nekobako/Mew40/README.md

| English | [日本語](README-ja-jp.md) |

# Mew40
A low-profile, unibody keyboard with a 40% ortholinear layout.

Mew40 CNC

Mew40 3DP

## Key Features
- 48-key ortholinear layout arranged in 4 rows of 12 keys
- Hot-swappable 3-pin switches compatible with Choc V2
- Full color backlighting for every key
- Choice of an aluminum case machined by CNC or a resin case made with 3D printing
- Keymap customization with Vial

## Build Guide
[Build Guide | Mew40](https://mew40.nekobako.net/build-guide/)

## License
| Component | License | Third Party Notices |
| --- | --- | --- |
| [PCB](./PCB/) | [LICENSE.md](./PCB/LICENSE.md) | [THIRD-PARTY-NOTICES.md](./PCB/THIRD-PARTY-NOTICES.md) |
| [Case](./Case/) | [LICENSE.md](./Case/LICENSE.md) | [THIRD-PARTY-NOTICES.md](./Case/THIRD-PARTY-NOTICES.md) |
| [Firmware](./Firmware/) | [LICENSE.md](./Firmware/LICENSE.md) | [THIRD-PARTY-NOTICES.md](./Firmware/THIRD-PARTY-NOTICES.md) |
