nekobako/Mew40/Website/en-us/index.md

---
layout: home
hero:
  name: "Mew40"
  tagline: "A low-profile, unibody keyboard\nwith a 40% ortholinear layout"
  image:
    src: "/images/mew40-cnc.png"
    alt: "Mew40"
  actions:
    - theme: brand
      text: "Buy on BOOTH"
      link: "https://nekobako.booth.pm"
    - theme: alt
      text: "Build Guide"
      link: "./build-guide/"
features:
  - icon: "⌨️"
    title: "40% Ortholinear Layout"
    details: "48-key ortholinear layout arranged in 4 rows of 12 keys"
  - icon: "🍫"
    title: "Low Profile"
    details: "Hot-swappable 3-pin switches compatible with Choc V2"
  - icon: "🌈"
    title: "Per-Key RGB Backlighting"
    details: "Full color backlighting for every key"
  - icon: "⚗️"
    title: "Custom Keymaps"
    details: "Keymap customization with Vial"
---
