nekobako/Mew40/Website/en-us/license/index.md

# License
License information for the Mew40 DIY keyboard kit.

- [PCB](./pcb)
- [Case](./case)
- [Firmware](./firmware)
