nekobako/Mew40/Website/ja-jp/license/index.md

# ライセンス
自作キーボードキット Mew40 のライセンス情報です。

- [基板](./pcb)
- [ケース](./case)
- [ファームウェア](./firmware)
