nekobako/Mew40/Website/ja-jp/index.md

---
layout: home
hero:
  name: "Mew40"
  tagline: "40% オーソリニア配列を採用した\nロープロファイルの一体型キーボード"
  image:
    src: "/images/mew40-cnc.png"
    alt: "Mew40"
  actions:
    - theme: brand
      text: "BOOTH で購入"
      link: "https://nekobako.booth.pm"
    - theme: alt
      text: "ビルドガイド"
      link: "./build-guide/"
features:
  - icon: "⌨️"
    title: "40% オーソリニア配列"
    details: "4 行 × 12 列、計 48 キーのオーソリニア配列"
  - icon: "🍫"
    title: "ロープロファイル"
    details: "Choc V2 互換 3 ピンスイッチのホットスワップに対応"
  - icon: "🌈"
    title: "バックライト搭載"
    details: "すべてのキーにフルカラーバックライトを搭載"
  - icon: "⚗️"
    title: "カスタムキーマップ"
    details: "Vial によるキーマップ変更に対応"
---
