nekobako/Mew40/Case/Mew40_3DP.FCStd

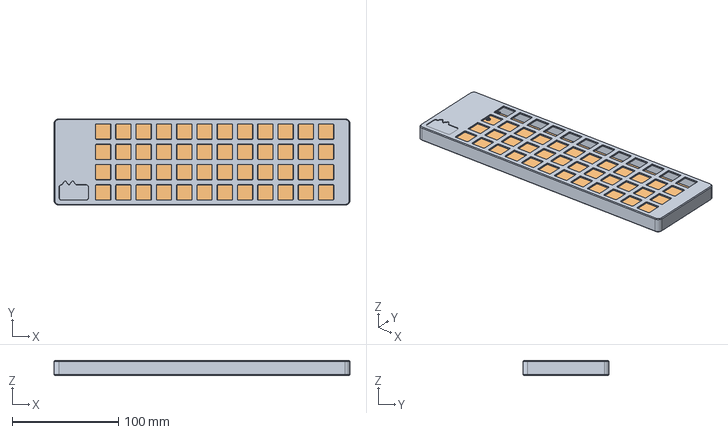
[picture p1: CAD file, 2026-11-14]
Case/Mew40_3DP.FCStd
278.2 x 81.2 x 14.0 mm
Top_Body
Bottom_Body
