nekobako/Mew40/Case/Mew40_CNC.FCStd

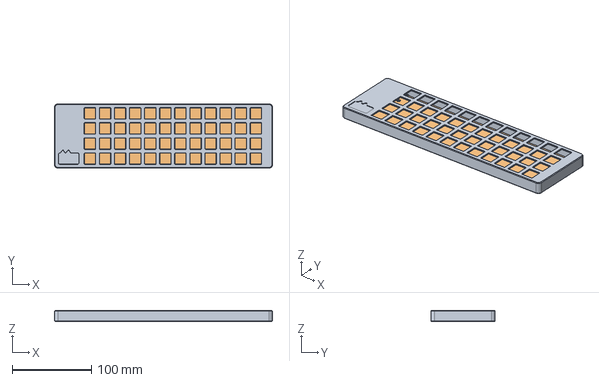
[picture p2: CAD file, 2026-11-14]
Case/Mew40_CNC.FCStd
275.3 x 81.2 x 14.0 mm
Top_Body
Bottom_Body
