nekobako/Mew40/Website/en-us/build-guide/index.md

# Build Guide
Build guide for the Mew40 DIY keyboard kit.

- [Preparation](./preparation)
- [Soldering](./soldering)
- [Assembly](./assembly)
- [Firmware](./firmware)
- [Finishing](./finishing)
