nekobako/Mew40/Website/ja-jp/build-guide/index.md

# ビルドガイド
自作キーボードキット Mew40 のビルドガイドです。

- [準備](./preparation)
- [はんだ付け](./soldering)
- [組み立て](./assembly)
- [ファームウェア](./firmware)
- [仕上げ](./finishing)
