nekobako/Mew40/Website/images/build-guide/finishing/3.png

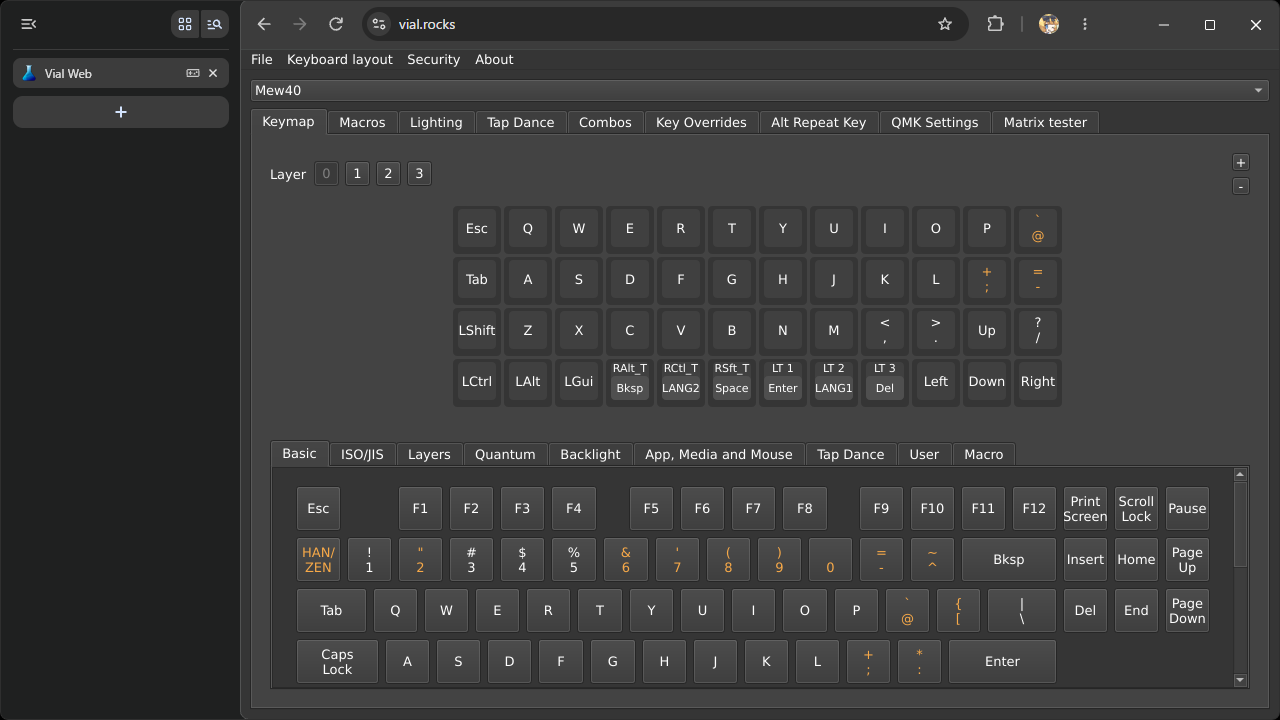
Website/images/build-guide/finishing/3.png
