nekobako/Mew40/Website/images/build-guide/finishing/4.png

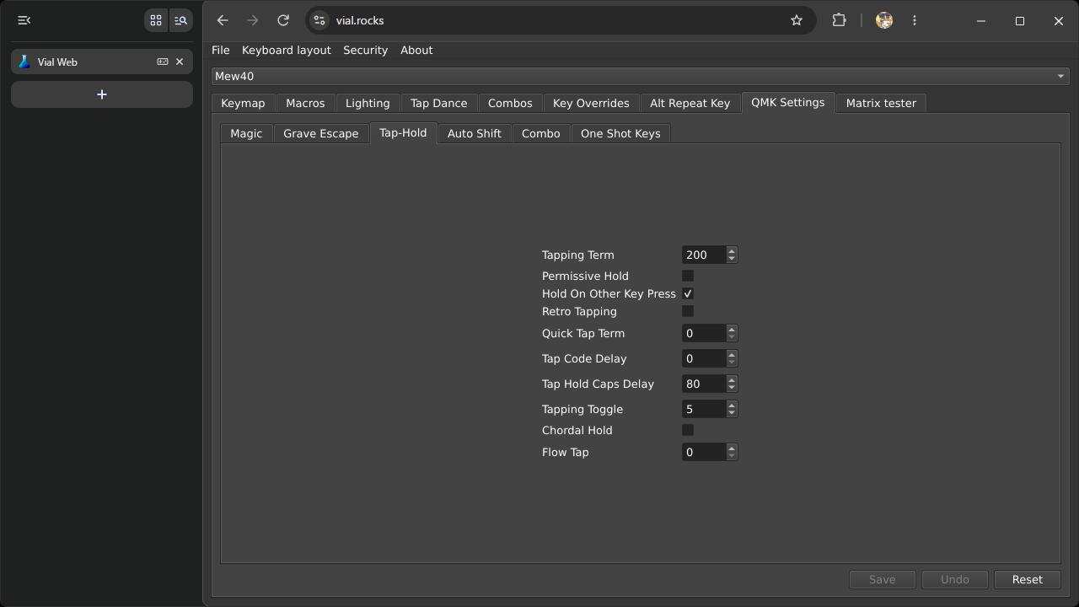
Website/images/build-guide/finishing/4.png
