nekobako/Mew40/Website/images/build-guide/firmware/2.png

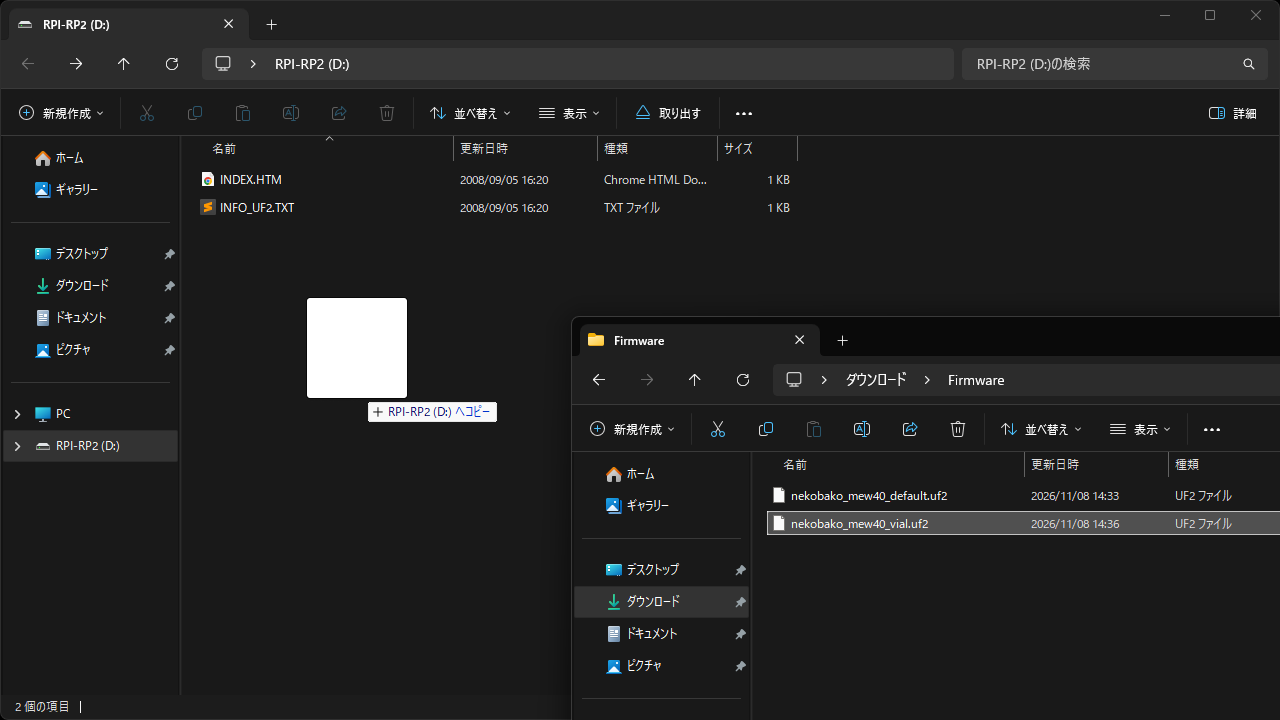
Website/images/build-guide/firmware/2.png
