nekobako/Mew40/Website/images/build-guide/firmware/3.png

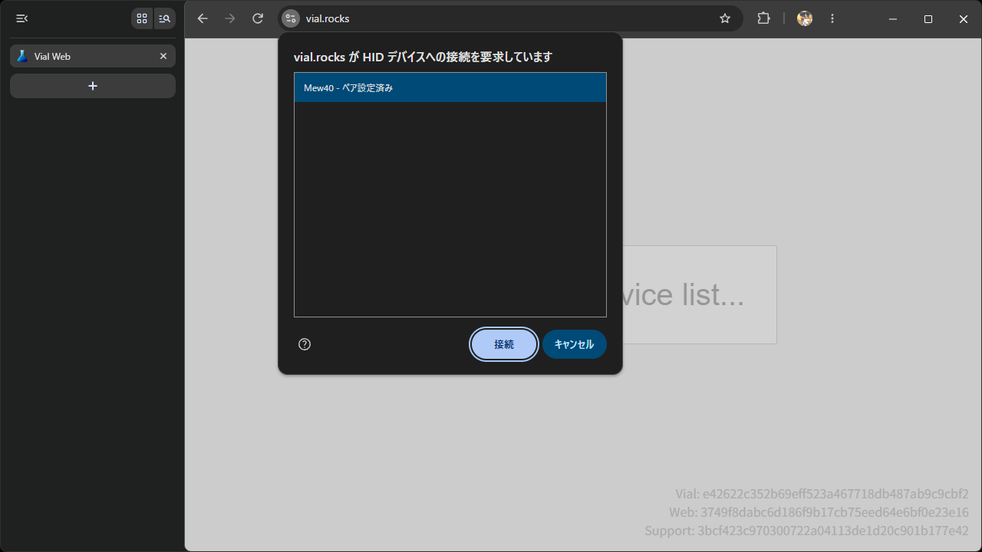
Website/images/build-guide/firmware/3.png
