nekobako/Mew40/PCB/Mew40.kicad_pcb

## KiCad design PCB/Mew40.kicad_pcb (2026-11-14)

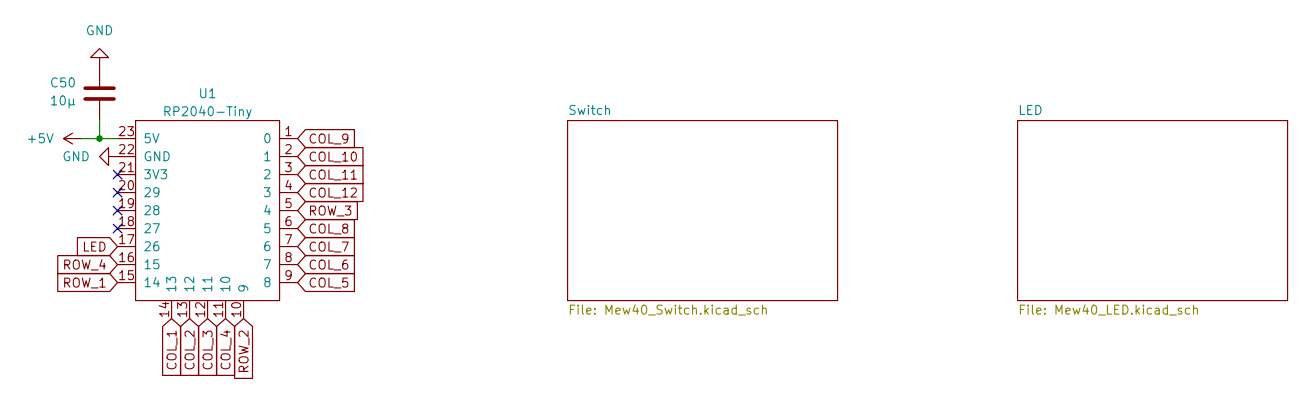
[picture p8: schematic Mew40.kicad_sch]

Parts:
C50: 10µ; C_1206_3216Metric
U1: RP2040-Tiny; Waveshare_RP2040-Zero_SMD

Connections:
+5V: C50.2, U1.23 (5V); also elsewhere on the board
COL_1: U1.14 (13); also elsewhere on the board
COL_2: U1.13 (12); also elsewhere on the board
COL_3: U1.12 (11); also elsewhere on the board
COL_4: U1.11 (10); also elsewhere on the board
COL_5: U1.9 (8); also elsewhere on the board
COL_6: U1.8 (7); also elsewhere on the board
COL_7: U1.7 (6); also elsewhere on the board
COL_8: U1.6 (5); also elsewhere on the board
COL_9: U1.1 (0); also elsewhere on the board
COL_10: U1.2 (1); also elsewhere on the board
COL_11: U1.3 (2); also elsewhere on the board
COL_12: U1.4 (3); also elsewhere on the board
GND: C50.1, U1.22 (GND); also elsewhere on the board
LED: U1.17 (26); also elsewhere on the board
ROW_1: U1.15 (14); also elsewhere on the board
ROW_2: U1.10 (9); also elsewhere on the board
ROW_3: U1.5 (4); also elsewhere on the board
ROW_4: U1.16 (15); also elsewhere on the board

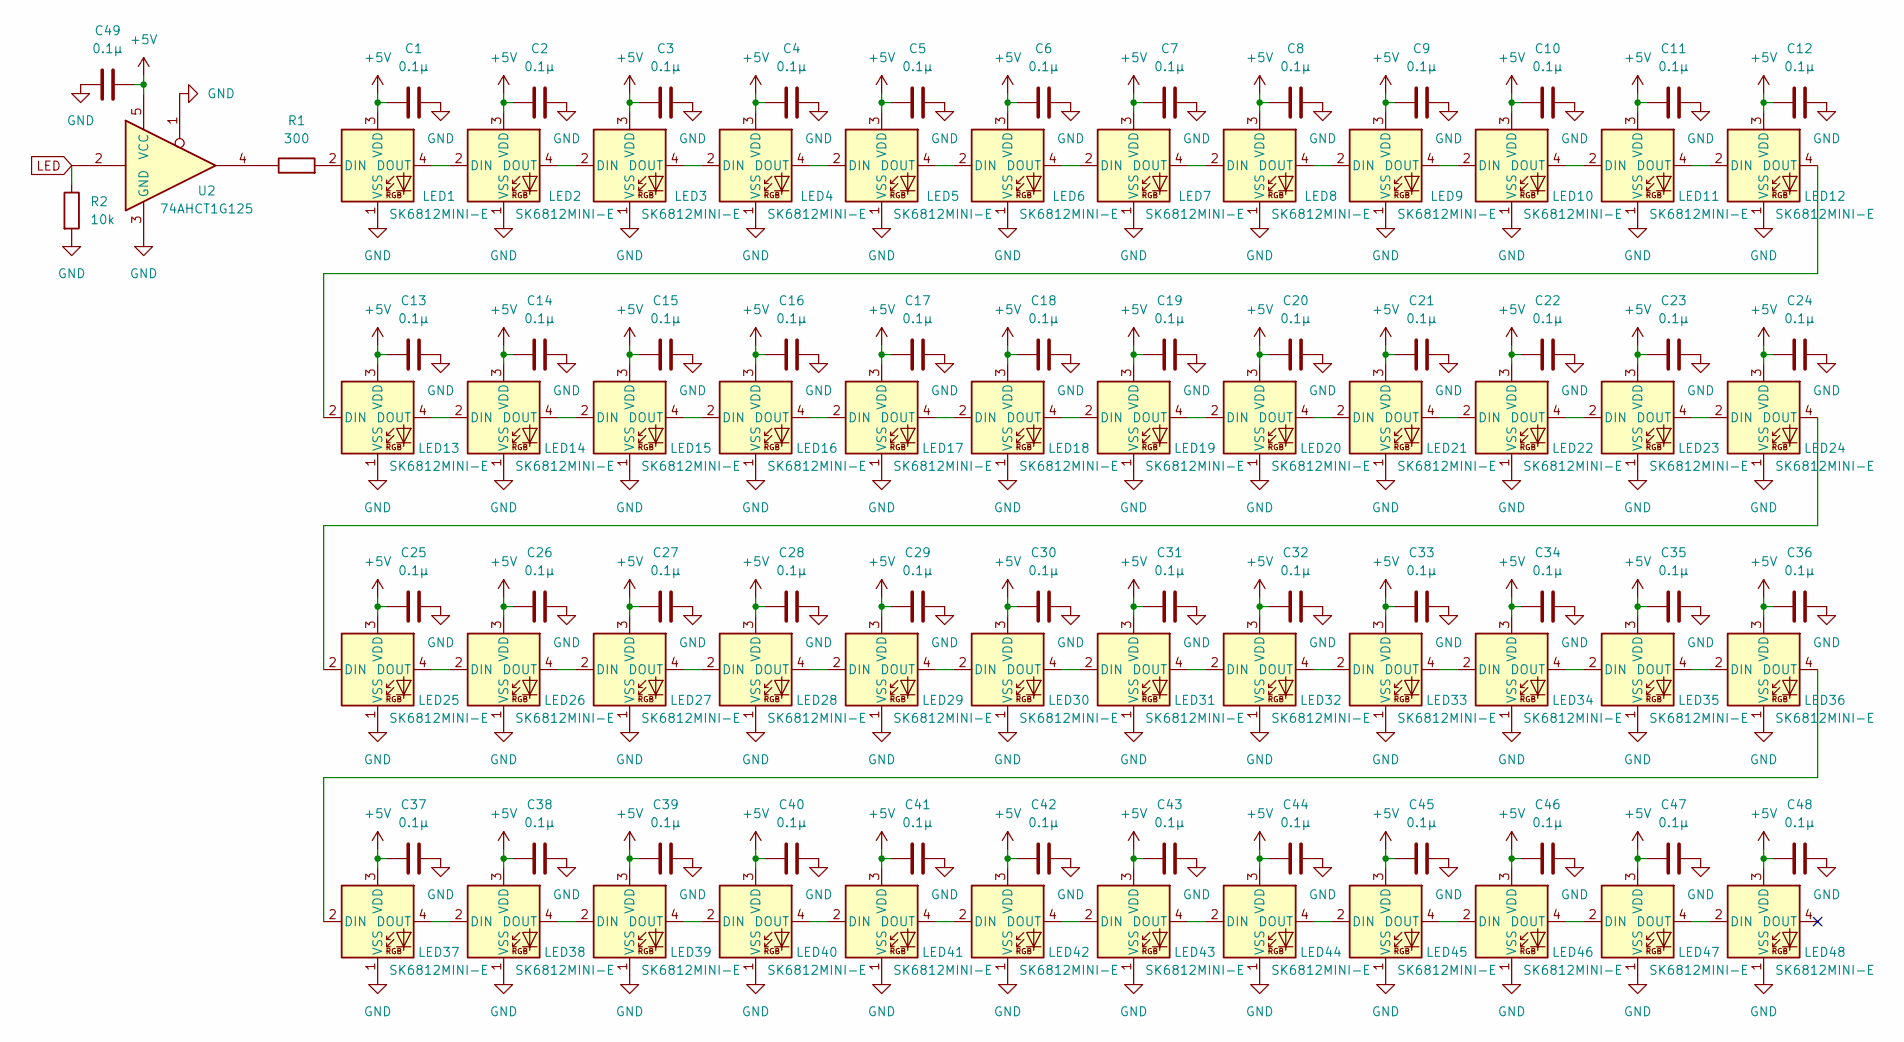
[picture p9: schematic Mew40_LED.kicad_sch, Mew40]

Parts:
C1, C2, C3, C4, C5, C6, C7, C8, C9, C10, C11, C12, C13, C14, C15, C16, C17, C18, C19, C20, C21, C22, C23, C24, C25, C26, C27, C28, C29, C30, C31, C32, C33, C34, C35, C36, C37, C38, C39, C40, C41, C42, C43, C44, C45, C46, C47, C48, C49: 0.1µ; C_0603_1608Metric
LED1, LED2, LED3, LED4, LED5, LED6, LED7, LED8, LED9, LED10, LED11, LED12, LED13, LED14, LED15, LED16, LED17, LED18, LED19, LED20, LED21, LED22, LED23, LED24, LED25, LED26, LED27, LED28, LED29, LED30, LED31, LED32, LED33, LED34, LED35, LED36, LED37, LED38, LED39, LED40, LED41, LED42, LED43, LED44, LED45, LED46, LED47, LED48: SK6812MINI-E; LED_SK6812MINI-E_3.2x2.8mm_P1.5mm_ReverseMount
R1: 300; R_0603_1608Metric
R2: 10k; R_0603_1608Metric
U2: 74AHCT1G125; SOT-23-5

Connections:
+5V: C1.1, C2.1, C3.1, C4.1, C5.1, C6.1, C7.1, C8.1, C9.1, C10.1, C11.1, C12.1, C13.1, C14.1, C15.1, C16.1, C17.1, C18.1, C19.1, C20.1, C21.1, C22.1, C23.1, C24.1, C25.1, C26.1, C27.1, C28.1, C29.1, C30.1, C31.1, C32.1, C33.1, C34.1, C35.1, C36.1, C37.1, C38.1, C39.1, C40.1, C41.1, C42.1, C43.1, C44.1, C45.1, C46.1, C47.1, C48.1, C49.2, LED1.3 (VDD), LED2.3 (VDD), LED3.3 (VDD), LED4.3 (VDD), LED5.3 (VDD), LED6.3 (VDD), LED7.3 (VDD), LED8.3 (VDD), LED9.3 (VDD), LED10.3 (VDD), LED11.3 (VDD), LED12.3 (VDD), LED13.3 (VDD), LED14.3 (VDD), LED15.3 (VDD), LED16.3 (VDD), LED17.3 (VDD), LED18.3 (VDD), LED19.3 (VDD), LED20.3 (VDD), LED21.3 (VDD), LED22.3 (VDD), LED23.3 (VDD), LED24.3 (VDD), LED25.3 (VDD), LED26.3 (VDD), LED27.3 (VDD), LED28.3 (VDD), LED29.3 (VDD), LED30.3 (VDD), LED31.3 (VDD), LED32.3 (VDD), LED33.3 (VDD), LED34.3 (VDD), LED35.3 (VDD), LED36.3 (VDD), LED37.3 (VDD), LED38.3 (VDD), LED39.3 (VDD), LED40.3 (VDD), LED41.3 (VDD), LED42.3 (VDD), LED43.3 (VDD), LED44.3 (VDD), LED45.3 (VDD), LED46.3 (VDD), LED47.3 (VDD), LED48.3 (VDD), U2.5 (VCC); also elsewhere on the board
GND: C1.2, C2.2, C3.2, C4.2, C5.2, C6.2, C7.2, C8.2, C9.2, C10.2, C11.2, C12.2, C13.2, C14.2, C15.2, C16.2, C17.2, C18.2, C19.2, C20.2, C21.2, C22.2, C23.2, C24.2, C25.2, C26.2, C27.2, C28.2, C29.2, C30.2, C31.2, C32.2, C33.2, C34.2, C35.2, C36.2, C37.2, C38.2, C39.2, C40.2, C41.2, C42.2, C43.2, C44.2, C45.2, C46.2, C47.2, C48.2, C49.1, LED1.1 (VSS), LED2.1 (VSS), LED3.1 (VSS), LED4.1 (VSS), LED5.1 (VSS), LED6.1 (VSS), LED7.1 (VSS), LED8.1 (VSS), LED9.1 (VSS), LED10.1 (VSS), LED11.1 (VSS), LED12.1 (VSS), LED13.1 (VSS), LED14.1 (VSS), LED15.1 (VSS), LED16.1 (VSS), LED17.1 (VSS), LED18.1 (VSS), LED19.1 (VSS), LED20.1 (VSS), LED21.1 (VSS), LED22.1 (VSS), LED23.1 (VSS), LED24.1 (VSS), LED25.1 (VSS), LED26.1 (VSS), LED27.1 (VSS), LED28.1 (VSS), LED29.1 (VSS), LED30.1 (VSS), LED31.1 (VSS), LED32.1 (VSS), LED33.1 (VSS), LED34.1 (VSS), LED35.1 (VSS), LED36.1 (VSS), LED37.1 (VSS), LED38.1 (VSS), LED39.1 (VSS), LED40.1 (VSS), LED41.1 (VSS), LED42.1 (VSS), LED43.1 (VSS), LED44.1 (VSS), LED45.1 (VSS), LED46.1 (VSS), LED47.1 (VSS), LED48.1 (VSS), R2.2, U2.1, U2.3 (GND); also elsewhere on the board
LED: R2.1, U2.2; also elsewhere on the board
unnamed: LED1.2 (DIN), R1.2
unnamed: LED1.4 (DOUT), LED2.2 (DIN)
unnamed: LED2.4 (DOUT), LED3.2 (DIN)
unnamed: LED3.4 (DOUT), LED4.2 (DIN)
unnamed: LED4.4 (DOUT), LED5.2 (DIN)
unnamed: LED5.4 (DOUT), LED6.2 (DIN)
unnamed: LED6.4 (DOUT), LED7.2 (DIN)
unnamed: LED7.4 (DOUT), LED8.2 (DIN)
unnamed: LED8.4 (DOUT), LED9.2 (DIN)
unnamed: LED9.4 (DOUT), LED10.2 (DIN)
unnamed: LED10.4 (DOUT), LED11.2 (DIN)
unnamed: LED11.4 (DOUT), LED12.2 (DIN)
unnamed: LED12.4 (DOUT), LED13.2 (DIN)
unnamed: LED13.4 (DOUT), LED14.2 (DIN)
unnamed: LED14.4 (DOUT), LED15.2 (DIN)
unnamed: LED15.4 (DOUT), LED16.2 (DIN)
unnamed: LED16.4 (DOUT), LED17.2 (DIN)
unnamed: LED17.4 (DOUT), LED18.2 (DIN)
unnamed: LED18.4 (DOUT), LED19.2 (DIN)
unnamed: LED19.4 (DOUT), LED20.2 (DIN)
unnamed: LED20.4 (DOUT), LED21.2 (DIN)
unnamed: LED21.4 (DOUT), LED22.2 (DIN)
unnamed: LED22.4 (DOUT), LED23.2 (DIN)
unnamed: LED23.4 (DOUT), LED24.2 (DIN)
unnamed: LED24.4 (DOUT), LED25.2 (DIN)
unnamed: LED25.4 (DOUT), LED26.2 (DIN)
unnamed: LED26.4 (DOUT), LED27.2 (DIN)
unnamed: LED27.4 (DOUT), LED28.2 (DIN)
unnamed: LED28.4 (DOUT), LED29.2 (DIN)
unnamed: LED29.4 (DOUT), LED30.2 (DIN)
unnamed: LED30.4 (DOUT), LED31.2 (DIN)
unnamed: LED31.4 (DOUT), LED32.2 (DIN)
unnamed: LED32.4 (DOUT), LED33.2 (DIN)
unnamed: LED33.4 (DOUT), LED34.2 (DIN)
unnamed: LED34.4 (DOUT), LED35.2 (DIN)
unnamed: LED35.4 (DOUT), LED36.2 (DIN)
unnamed: LED36.4 (DOUT), LED37.2 (DIN)
unnamed: LED37.4 (DOUT), LED38.2 (DIN)
unnamed: LED38.4 (DOUT), LED39.2 (DIN)
unnamed: LED39.4 (DOUT), LED40.2 (DIN)
unnamed: LED40.4 (DOUT), LED41.2 (DIN)
unnamed: LED41.4 (DOUT), LED42.2 (DIN)
unnamed: LED42.4 (DOUT), LED43.2 (DIN)
unnamed: LED43.4 (DOUT), LED44.2 (DIN)
unnamed: LED44.4 (DOUT), LED45.2 (DIN)
unnamed: LED45.4 (DOUT), LED46.2 (DIN)
unnamed: LED46.4 (DOUT), LED47.2 (DIN)
unnamed: LED47.4 (DOUT), LED48.2 (DIN)
unnamed: R1.1, U2.4

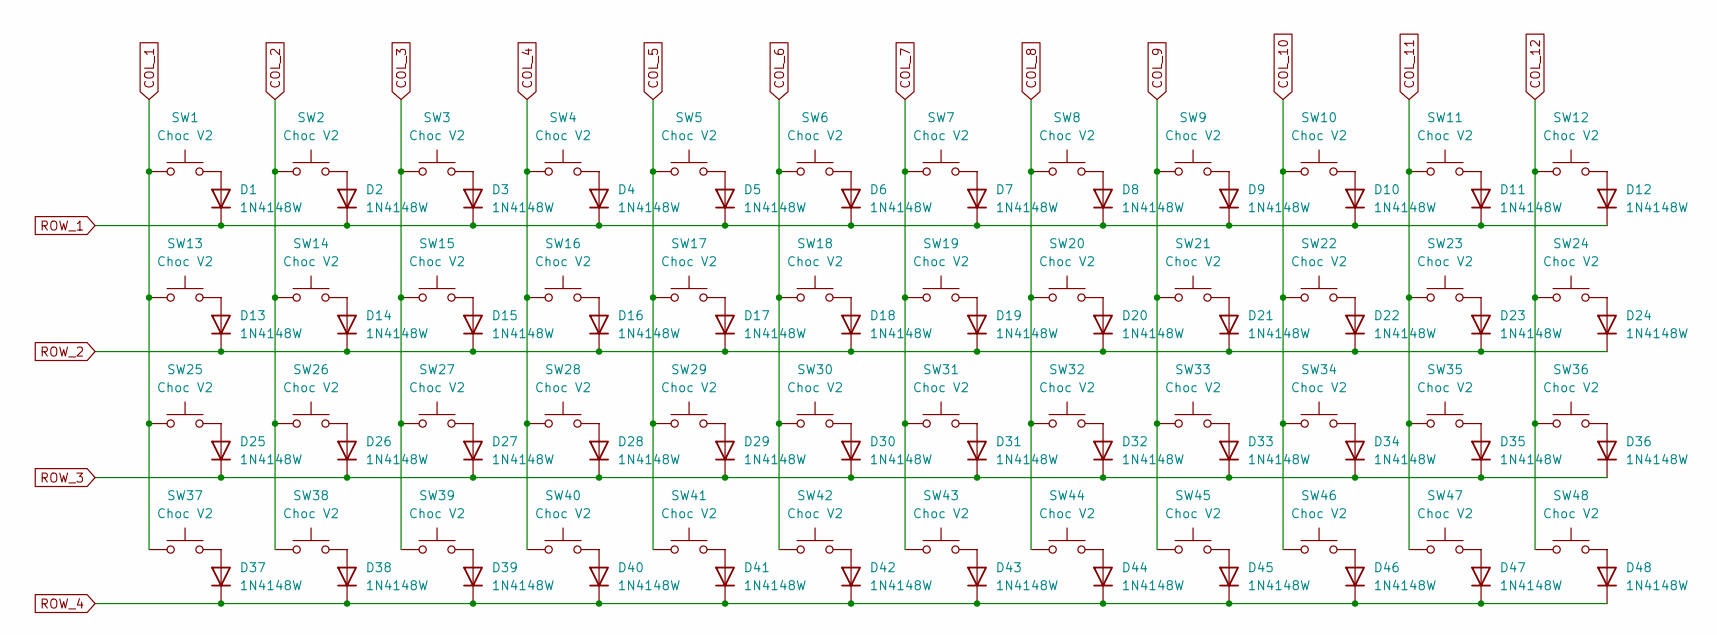
[picture p10: schematic Mew40_Switch.kicad_sch, Mew40]

Parts:
D1, D2, D3, D4, D5, D6, D7, D8, D9, D10, D11, D12, D13, D14, D15, D16, D17, D18, D19, D20, D21, D22, D23, D24, D25, D26, D27, D28, D29, D30, D31, D32, D33, D34, D35, D36, D37, D38, D39, D40, D41, D42, D43, D44, D45, D46, D47, D48: 1N4148W; D_SOD-123
SW1, SW2, SW3, SW4, SW5, SW6, SW7, SW8, SW9, SW10, SW11, SW12, SW13, SW14, SW15, SW16, SW17, SW18, SW19, SW20, SW21, SW22, SW23, SW24, SW25, SW26, SW27, SW28, SW29, SW30, SW31, SW32, SW33, SW34, SW35, SW36, SW37, SW38, SW39, SW40, SW41, SW42, SW43, SW44, SW45, SW46, SW47, SW48: Choc V2; SW_choc_v2_1u

Connections:
COL_1: SW1.1, SW13.1, SW25.1, SW37.1; also elsewhere on the board
COL_2: SW2.1, SW14.1, SW26.1, SW38.1; also elsewhere on the board
COL_3: SW3.1, SW15.1, SW27.1, SW39.1; also elsewhere on the board
COL_4: SW4.1, SW16.1, SW28.1, SW40.1; also elsewhere on the board
COL_5: SW5.1, SW17.1, SW29.1, SW41.1; also elsewhere on the board
COL_6: SW6.1, SW18.1, SW30.1, SW42.1; also elsewhere on the board
COL_7: SW7.1, SW19.1, SW31.1, SW43.1; also elsewhere on the board
COL_8: SW8.1, SW20.1, SW32.1, SW44.1; also elsewhere on the board
COL_9: SW9.1, SW21.1, SW33.1, SW45.1; also elsewhere on the board
COL_10: SW10.1, SW22.1, SW34.1, SW46.1; also elsewhere on the board
COL_11: SW11.1, SW23.1, SW35.1, SW47.1; also elsewhere on the board
COL_12: SW12.1, SW24.1, SW36.1, SW48.1; also elsewhere on the board
unnamed: D1.2 (A), SW1.2
unnamed: D2.2 (A), SW2.2
unnamed: D3.2 (A), SW3.2
unnamed: D4.2 (A), SW4.2
unnamed: D5.2 (A), SW5.2
unnamed: D6.2 (A), SW6.2
unnamed: D7.2 (A), SW7.2
unnamed: D8.2 (A), SW8.2
unnamed: D9.2 (A), SW9.2
unnamed: D10.2 (A), SW10.2
unnamed: D11.2 (A), SW11.2
unnamed: D12.2 (A), SW12.2
unnamed: D13.2 (A), SW13.2
unnamed: D14.2 (A), SW14.2
unnamed: D15.2 (A), SW15.2
unnamed: D16.2 (A), SW16.2
unnamed: D17.2 (A), SW17.2
unnamed: D18.2 (A), SW18.2
unnamed: D19.2 (A), SW19.2
unnamed: D20.2 (A), SW20.2
unnamed: D21.2 (A), SW21.2
unnamed: D22.2 (A), SW22.2
unnamed: D23.2 (A), SW23.2
unnamed: D24.2 (A), SW24.2
unnamed: D25.2 (A), SW25.2
unnamed: D26.2 (A), SW26.2
unnamed: D27.2 (A), SW27.2
unnamed: D28.2 (A), SW28.2
unnamed: D29.2 (A), SW29.2
unnamed: D30.2 (A), SW30.2
unnamed: D31.2 (A), SW31.2
unnamed: D32.2 (A), SW32.2
unnamed: D33.2 (A), SW33.2
unnamed: D34.2 (A), SW34.2
unnamed: D35.2 (A), SW35.2
unnamed: D36.2 (A), SW36.2
unnamed: D37.2 (A), SW37.2
unnamed: D38.2 (A), SW38.2
unnamed: D39.2 (A), SW39.2
unnamed: D40.2 (A), SW40.2
unnamed: D41.2 (A), SW41.2
unnamed: D42.2 (A), SW42.2
unnamed: D43.2 (A), SW43.2
unnamed: D44.2 (A), SW44.2
unnamed: D45.2 (A), SW45.2
unnamed: D46.2 (A), SW46.2
unnamed: D47.2 (A), SW47.2
unnamed: D48.2 (A), SW48.2
ROW_1: D1.1 (K), D2.1 (K), D3.1 (K), D4.1 (K), D5.1 (K), D6.1 (K), D7.1 (K), D8.1 (K), D9.1 (K), D10.1 (K), D11.1 (K), D12.1 (K); also elsewhere on the board
ROW_2: D13.1 (K), D14.1 (K), D15.1 (K), D16.1 (K), D17.1 (K), D18.1 (K), D19.1 (K), D20.1 (K), D21.1 (K), D22.1 (K), D23.1 (K), D24.1 (K); also elsewhere on the board
ROW_3: D25.1 (K), D26.1 (K), D27.1 (K), D28.1 (K), D29.1 (K), D30.1 (K), D31.1 (K), D32.1 (K), D33.1 (K), D34.1 (K), D35.1 (K), D36.1 (K); also elsewhere on the board
ROW_4: D37.1 (K), D38.1 (K), D39.1 (K), D40.1 (K), D41.1 (K), D42.1 (K), D43.1 (K), D44.1 (K), D45.1 (K), D46.1 (K), D47.1 (K), D48.1 (K); also elsewhere on the board

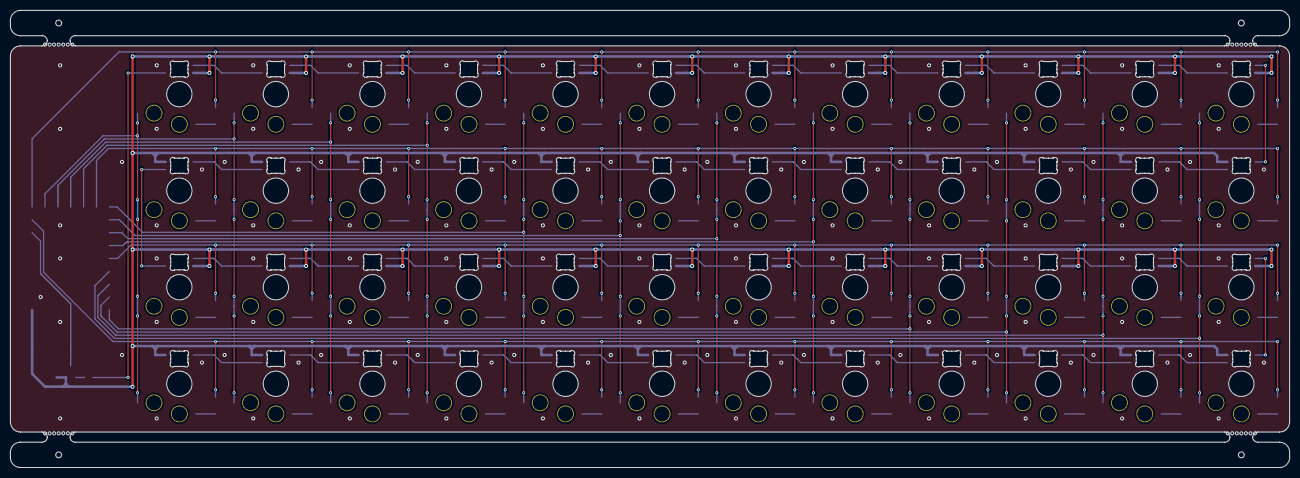
[picture p11: board Mew40.kicad_pcb from above]

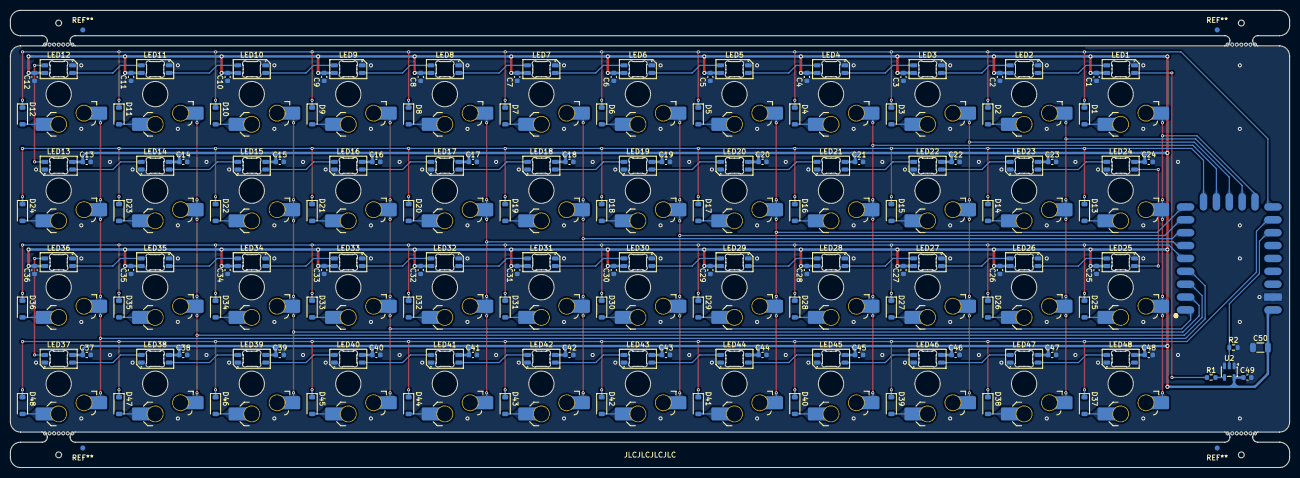
[picture p12: board Mew40.kicad_pcb from below]

Board: 2 copper layers, 252.4 x 90.2 mm, 198 parts (198 on the bottom side), 116 nets.
